crassociati/openWall/README.md

openWall
========

vertical plotting system
