crassociati/openWall/documents/openWall_instructionSet.pdf

# openWall

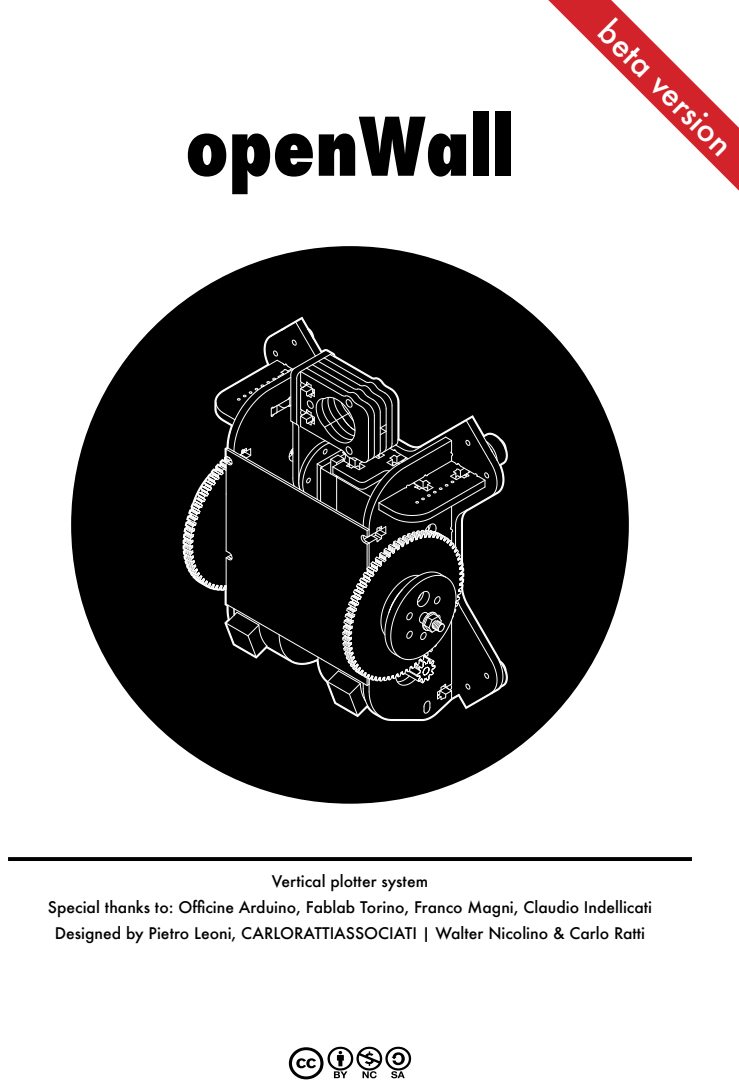
[picture p1: page 1]
beta version

Vertical plotter system

Special thanks to: Officine Arduino, Fablab Torino, Franco Magni, Claudio Indellicati
Designed by Pietro Leoni, carlorattiassociati | Walter Nicolino & Carlo Ratti

# connections and components

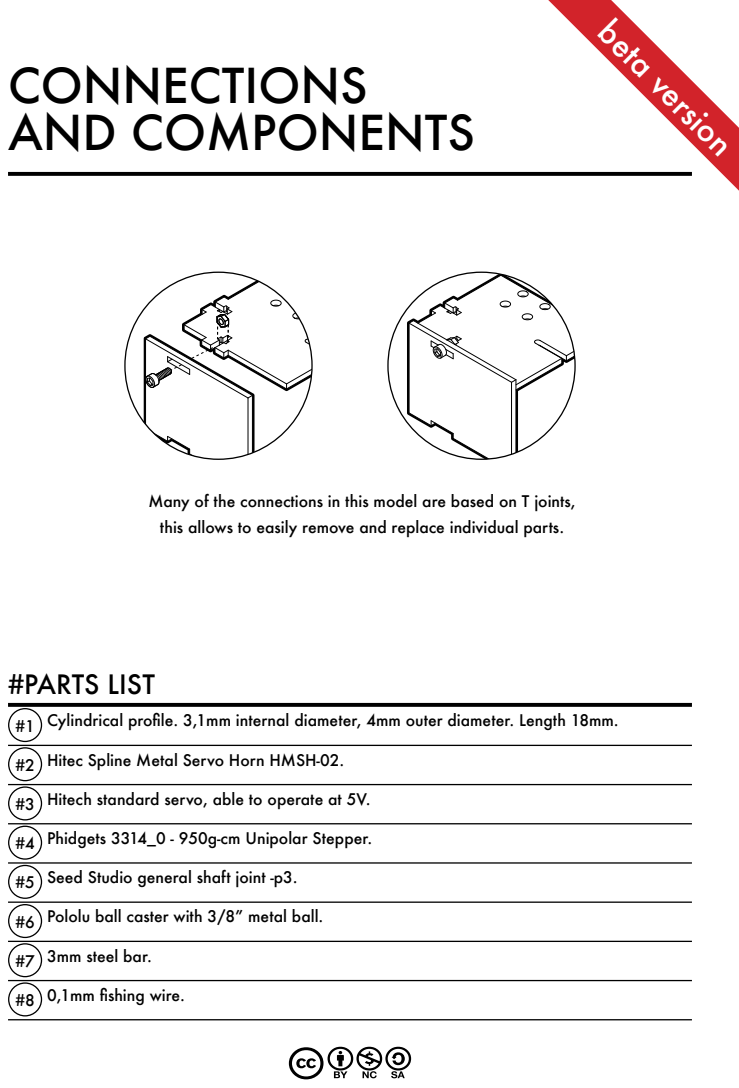
[picture p2: page 2]
beta version; #parts list

Many of the connections in this model are based on T joints,
this allows to easily remove and replace individual parts.

#1 Cylindrical profile. 3,1mm internal diameter, 4mm outer diameter. Length 18mm.
#2 Hitec Spline Metal Servo Horn HMSH-02.
#3 Hitech standard servo, able to operate at 5V.
#4 Phidgets 3314_0 - 950g-cm Unipolar Stepper.
#5 Seed Studio general shaft joint -p3.
#6 Pololu ball caster with 3/8” metal ball.
#7 3mm steel bar.
#8 0,1mm fishing wire.

# assembly

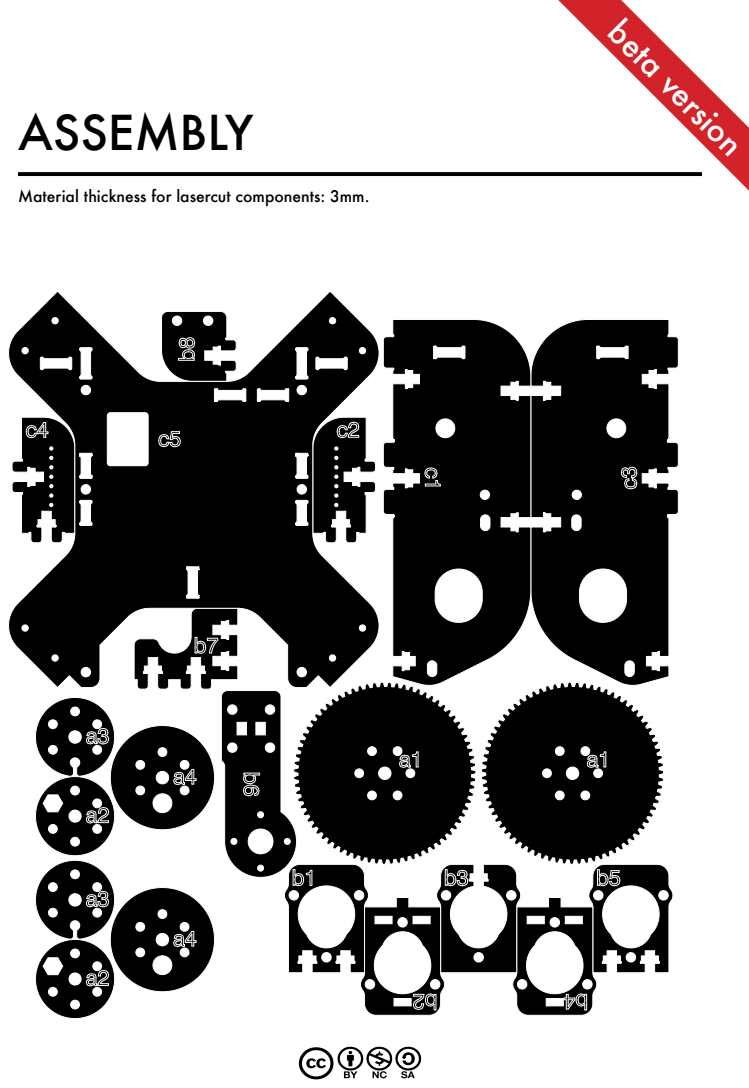
[picture p3: page 3]
beta version

Material thickness for lasercut components: 3mm.

# coils

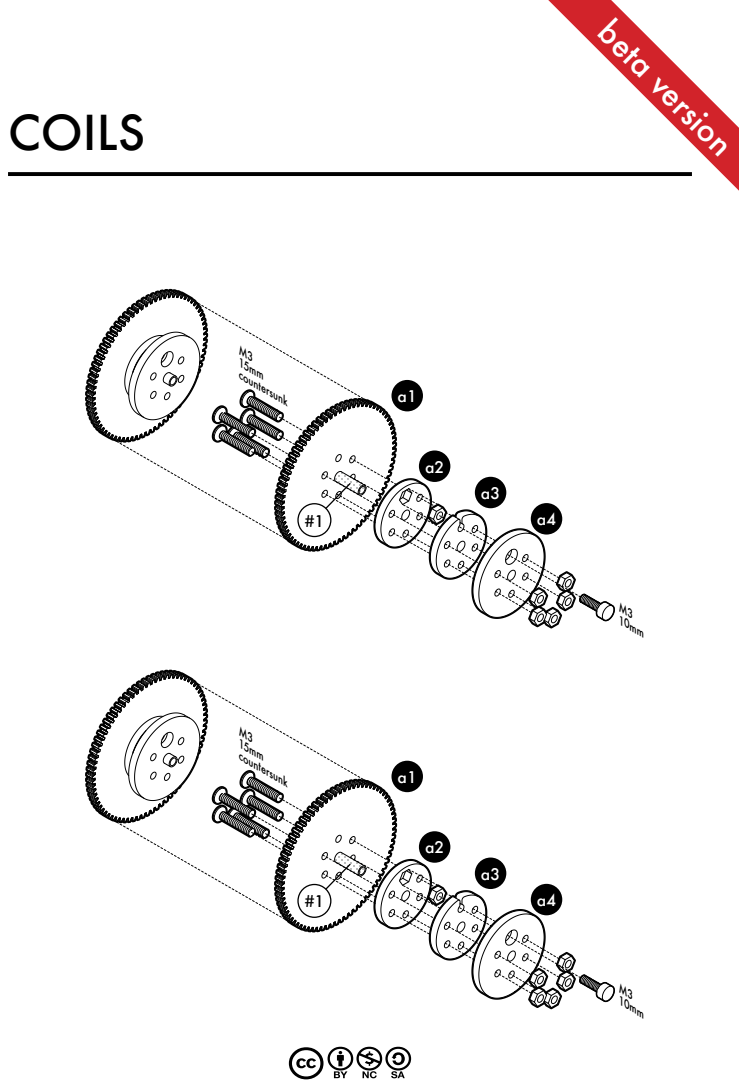
[picture p4: page 4]
beta version; M3 15mm countersunk

# servo and pen holder

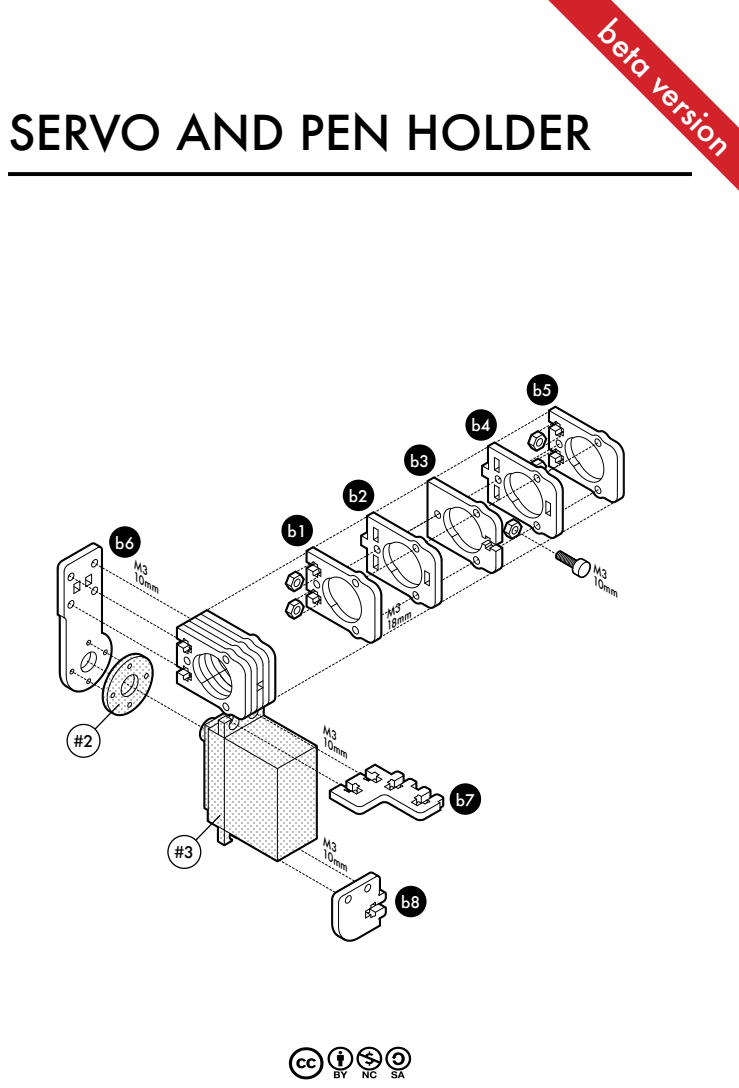
[picture p5: page 5]
beta version

# engines support

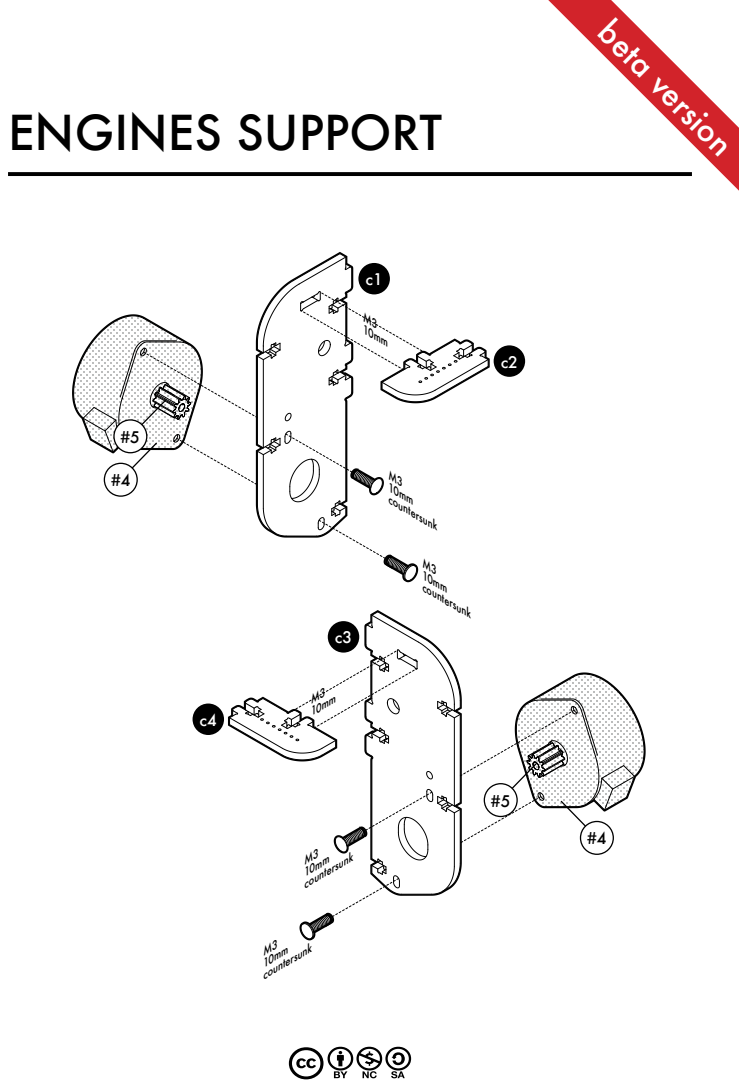
[picture p6: page 6]
beta version; M3 10mm countersunk; countersunk

# chassis

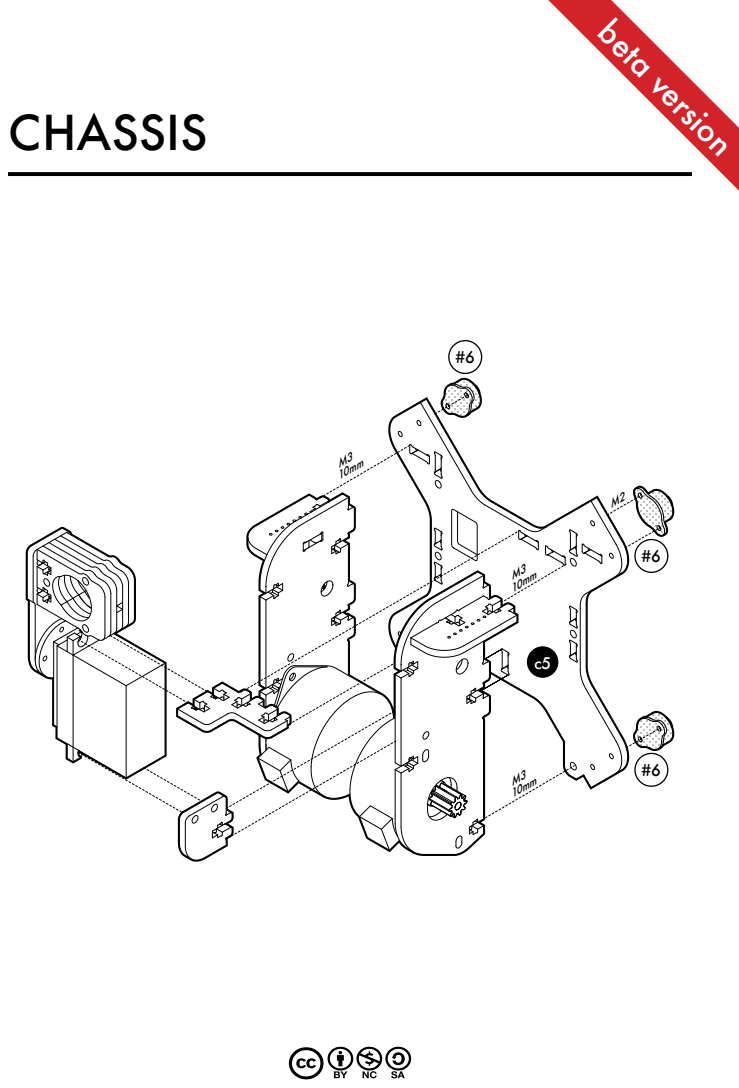
[picture p7: page 7]
beta version

# Coils axis

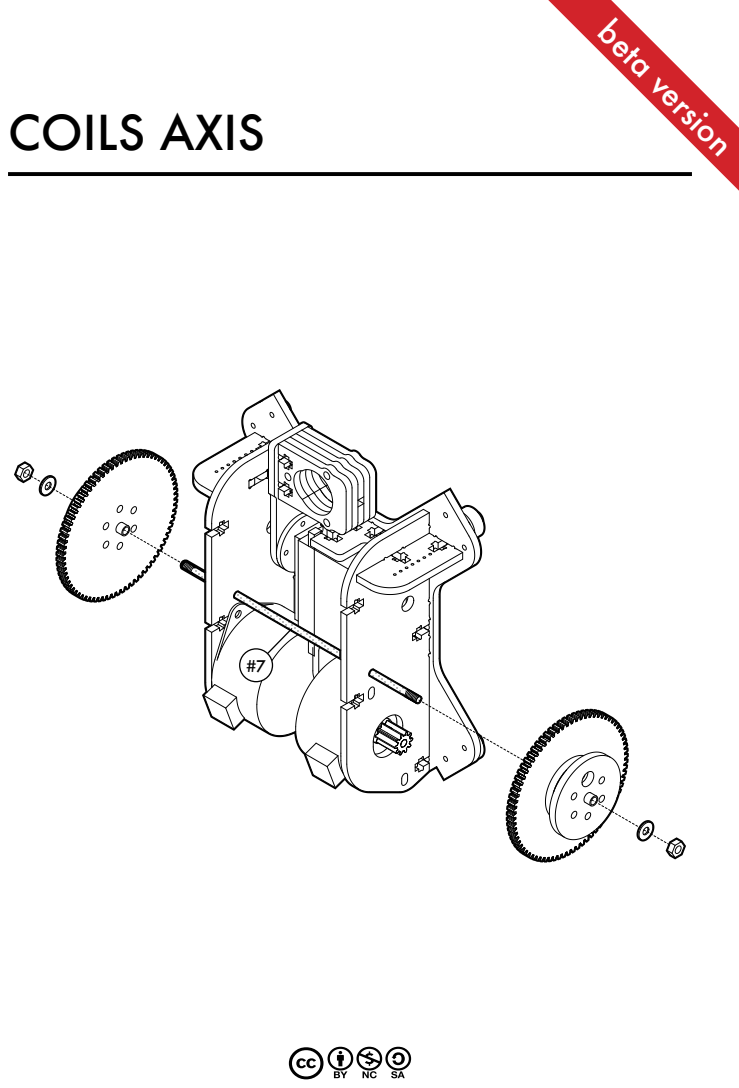
[picture p8: page 8]
beta version

# cables and marker

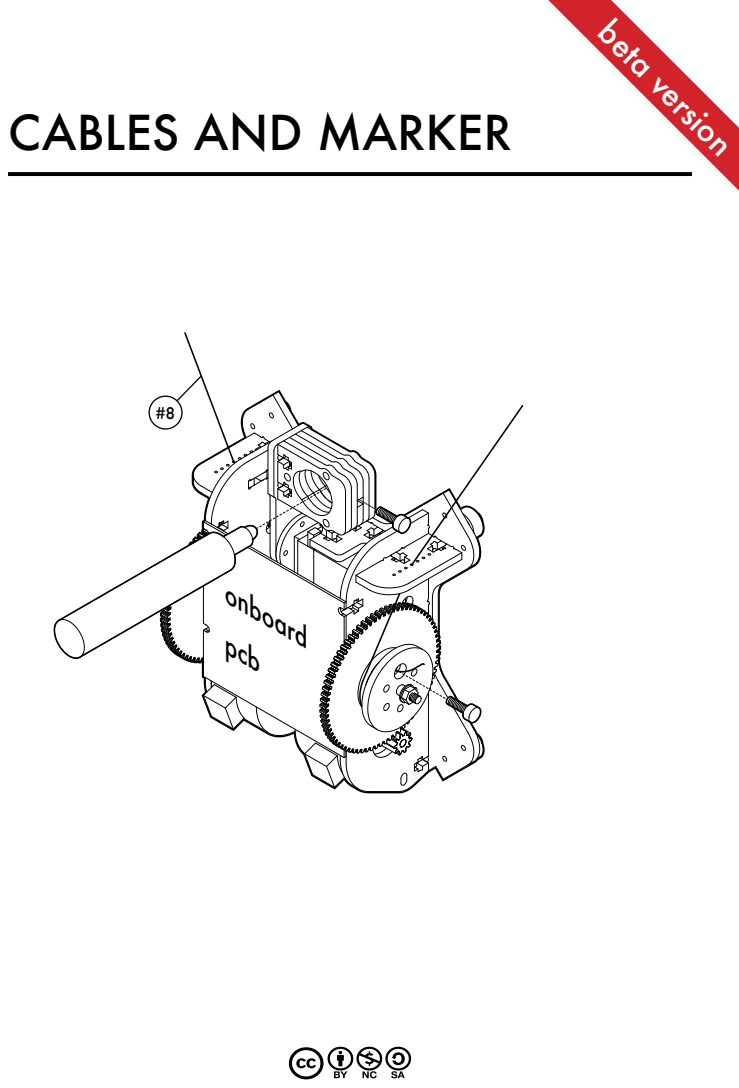
[picture p9: page 9]
beta version; onboard pcb

# hardware

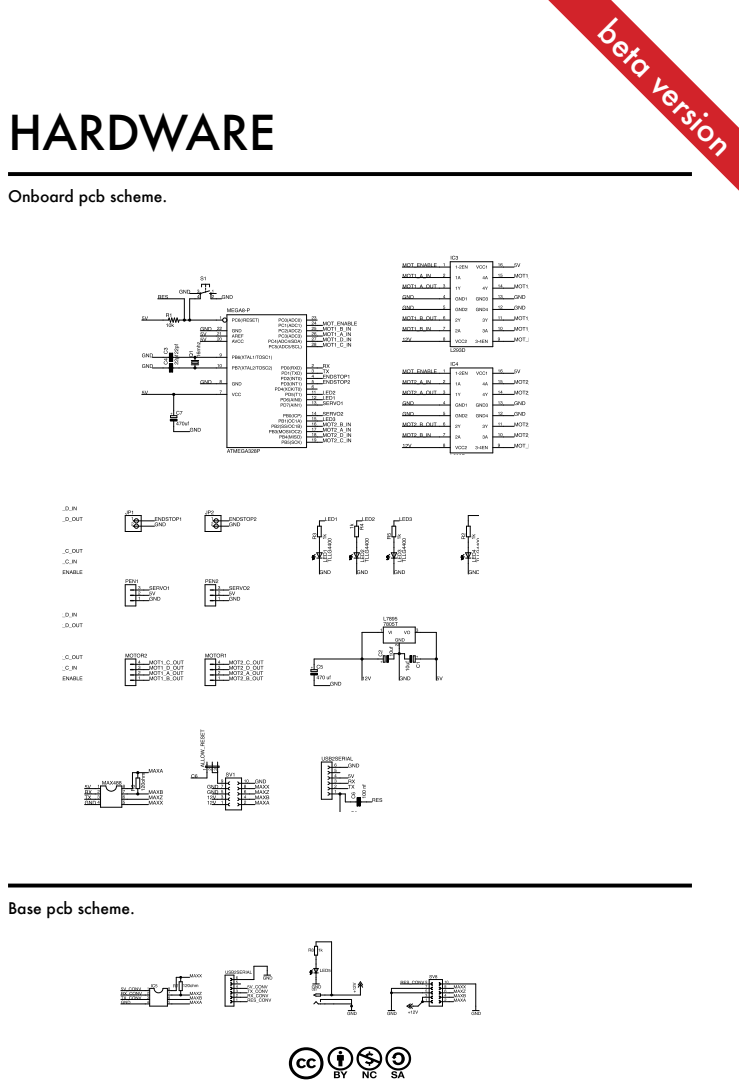
[picture p10: page 10]
beta version

Onboard pcb scheme.

Base pcb scheme.

# hardware

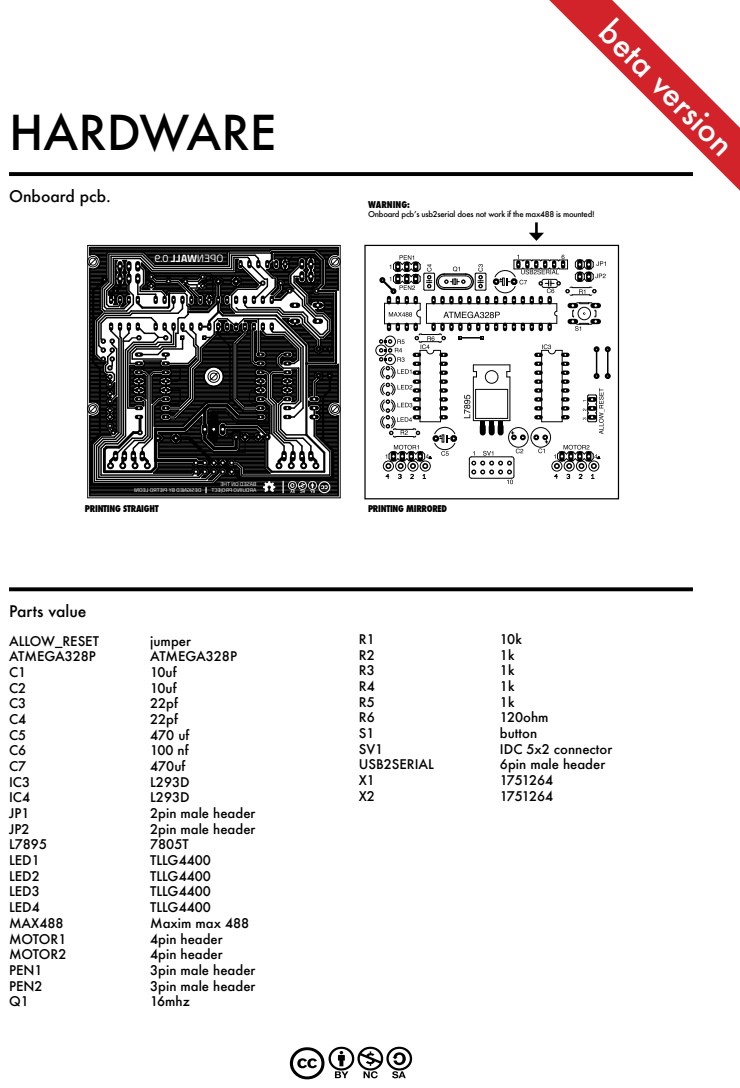
[picture p11: page 11]

warning:
Onboard pcb’s usb2serial does not work if the max488 is mounted!

# hardware

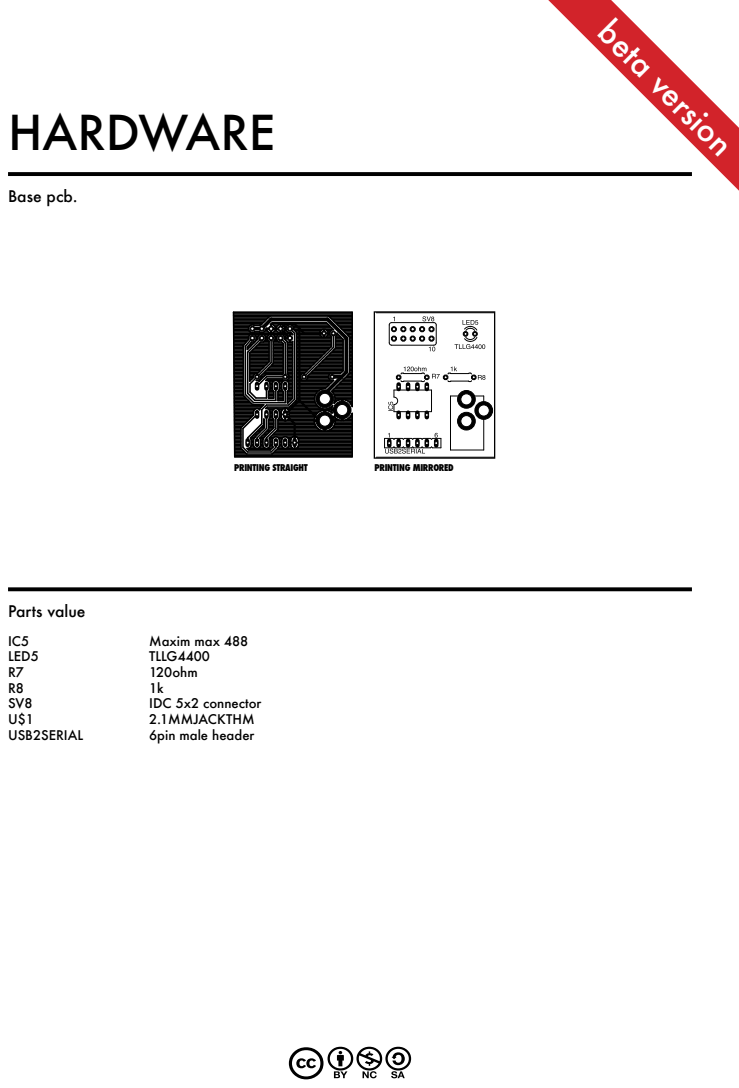
[picture p12: page 12]
beta version; Base pcb.; Parts value; Maxim max 488; LED5; TLLG4400; 120ohm; IDC 5x2 connector; 2.1MMJACKTHM; USB2SERIAL; 6pin male header; printing straight; printing mirrored

# beta version
