crassociati/openWall/documents/openWall_1.0_chassis.pdf

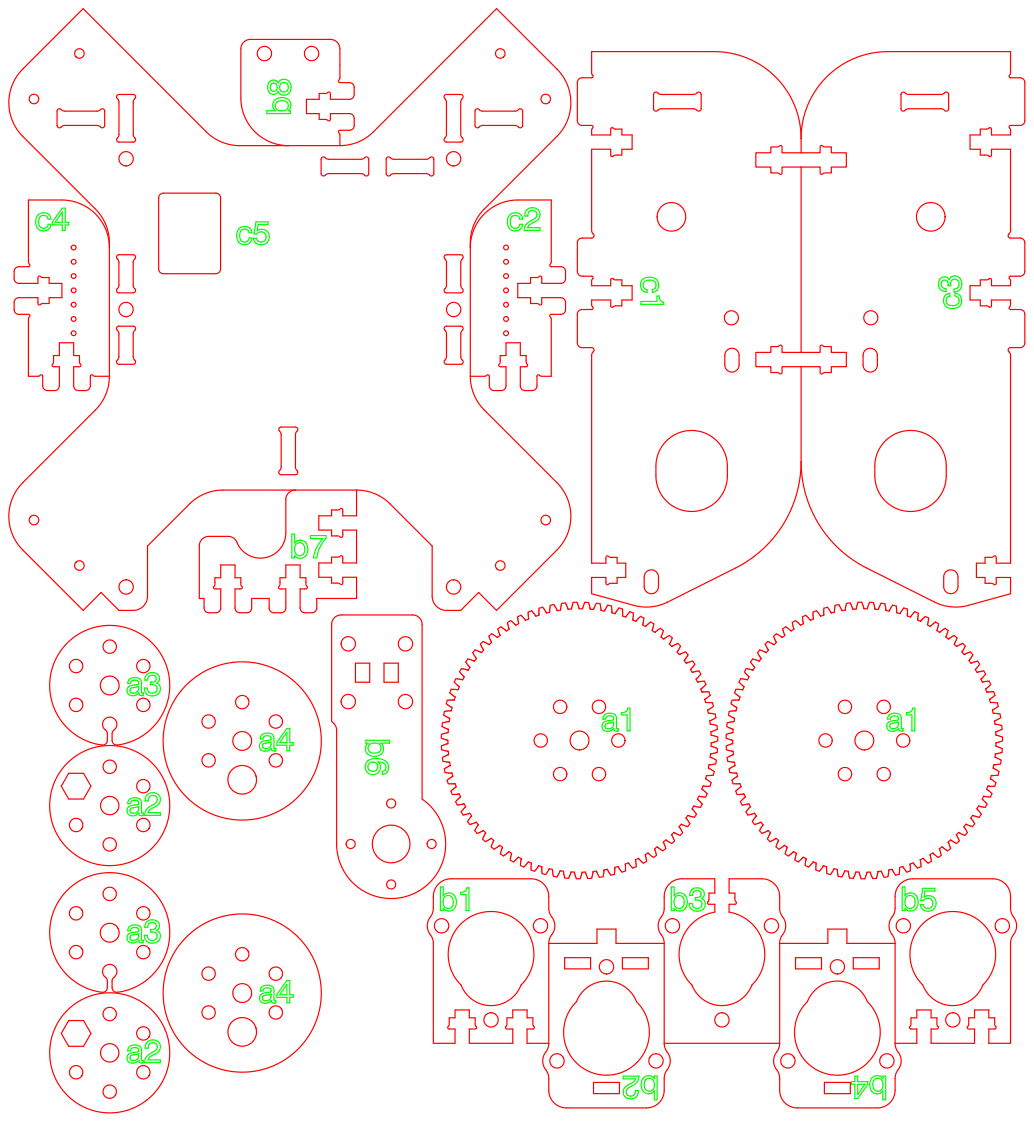
[picture p13: page 1]
