crassociati/openWall/circuits/openWall_BasePCB.brd

## EAGLE design circuits/openWall_BasePCB.brd (2014-04-22)

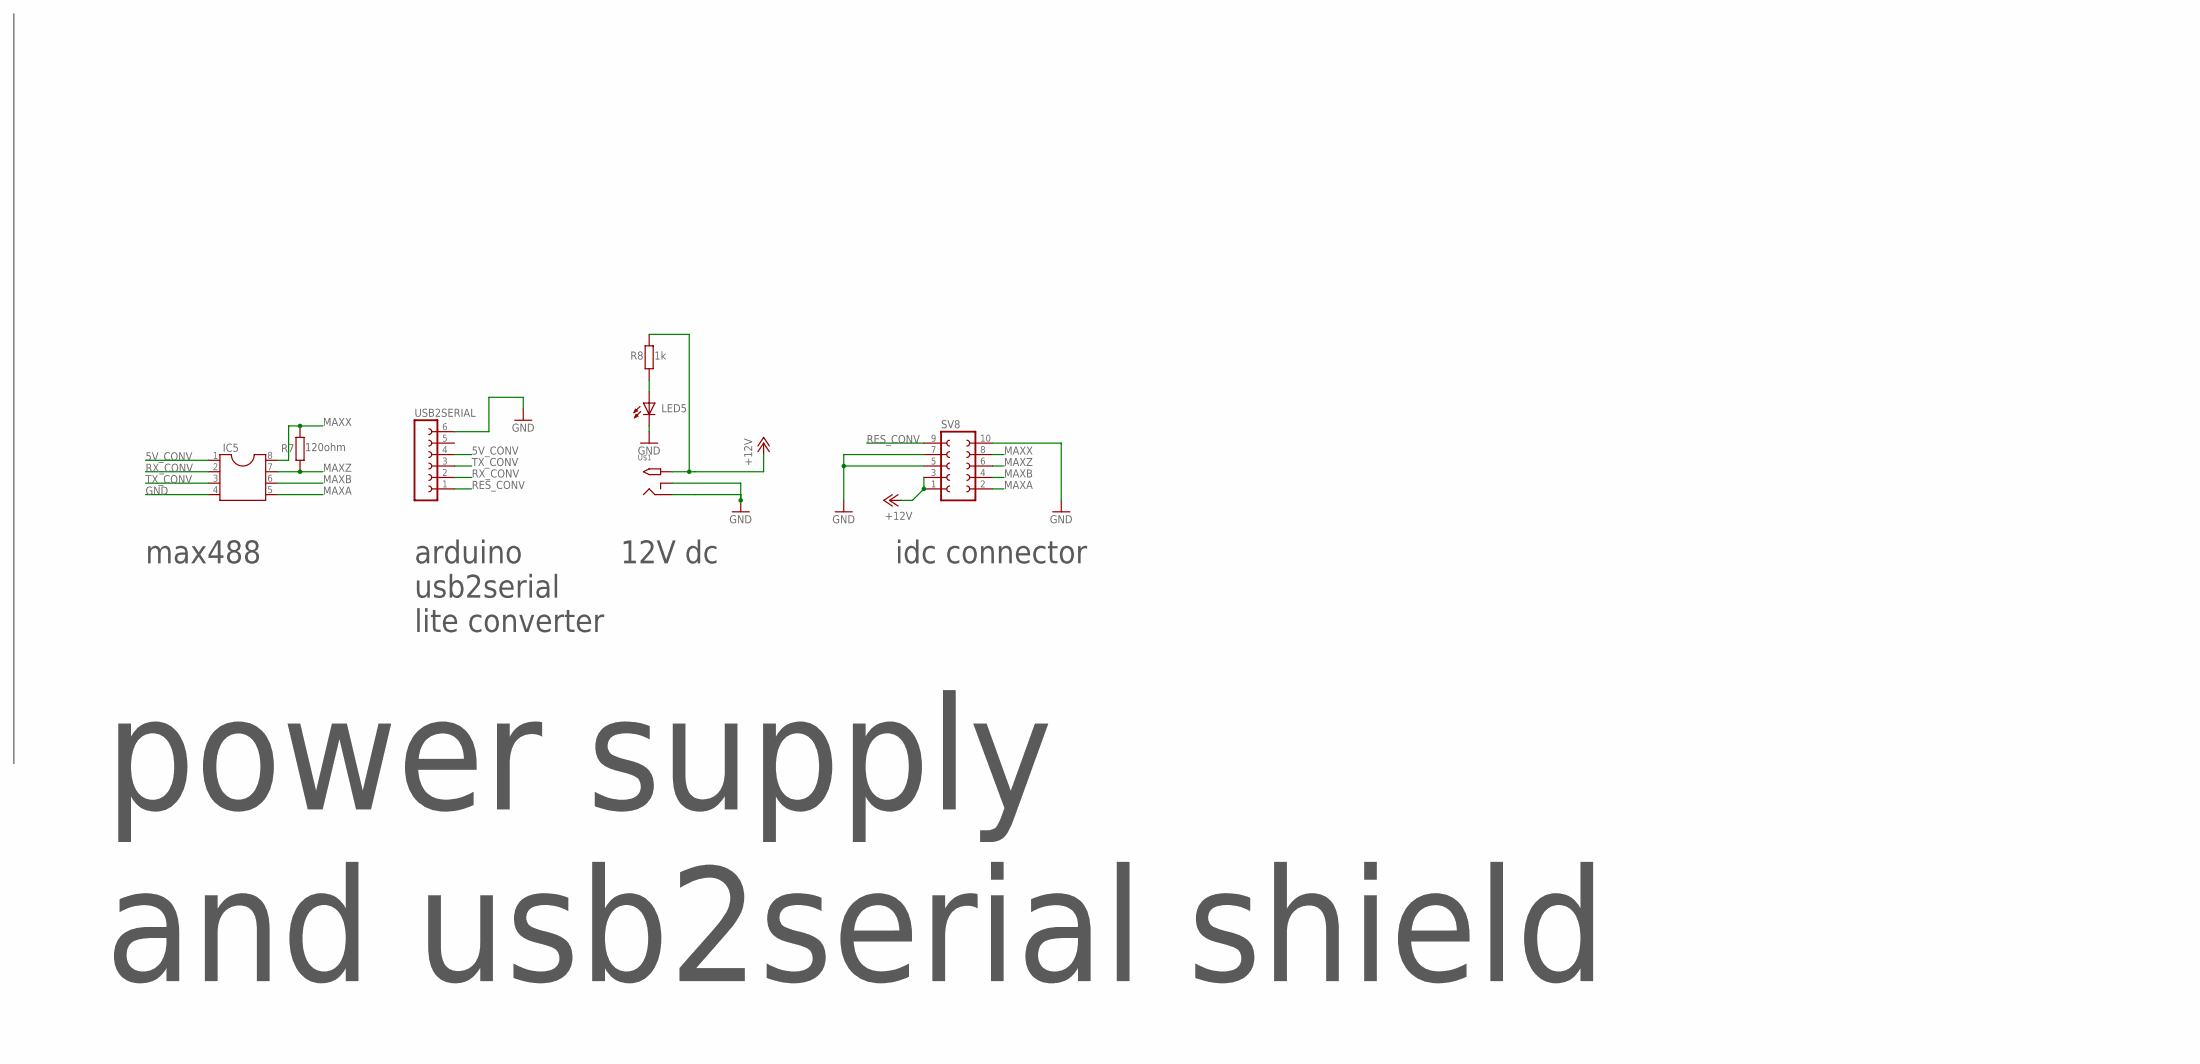
[picture p14: schematic openWall_BasePCB.sch]

Parts:
IC5: DIL8; DIL08
LED5: TLLG4400; LED3MM
R7: 120ohm; 0207/7
R8: 1k; 0207/7
SV8: FE05-2
U$1: 2.1MMJACKTHM; PJ-102A
USB2SERIAL: FE06-1; FE06

Connections:
5V_CONV: IC5.1, USB2SERIAL.4
12V: R8.2, U$1.TIP
+12V: SV8.1, SV8.3
GND: IC5.4, LED5.K (C), SV8.5, SV8.7, SV8.10, U$1.RING, U$1.RING_SW, USB2SERIAL.6
MAXA: IC5.5, SV8.2
MAXB: IC5.6, SV8.4
MAXX: IC5.8, R7.2, SV8.8
MAXZ: IC5.7, R7.1, SV8.6
unnamed: LED5.A, R8.1
RES_CONV: SV8.9, USB2SERIAL.1
RX_CONV: IC5.2, USB2SERIAL.2
TX_CONV: IC5.3, USB2SERIAL.3

Notes on the sheet:
arduino usb2serial lite converter
max488
12V dc
idc connector
power supply and usb2serial shield

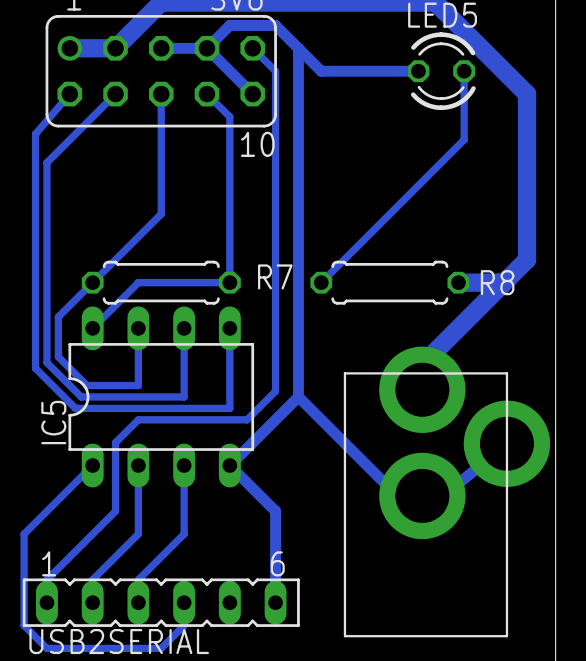
[picture p15: board openWall_BasePCB.brd from above]

Board: 2 copper layers, 7 parts (0 on the bottom side), 12 nets.
