crassociati/openWall/circuits/openWall_onBoardPCB.brd

## EAGLE design circuits/openWall_onBoardPCB.brd (2014-04-22)

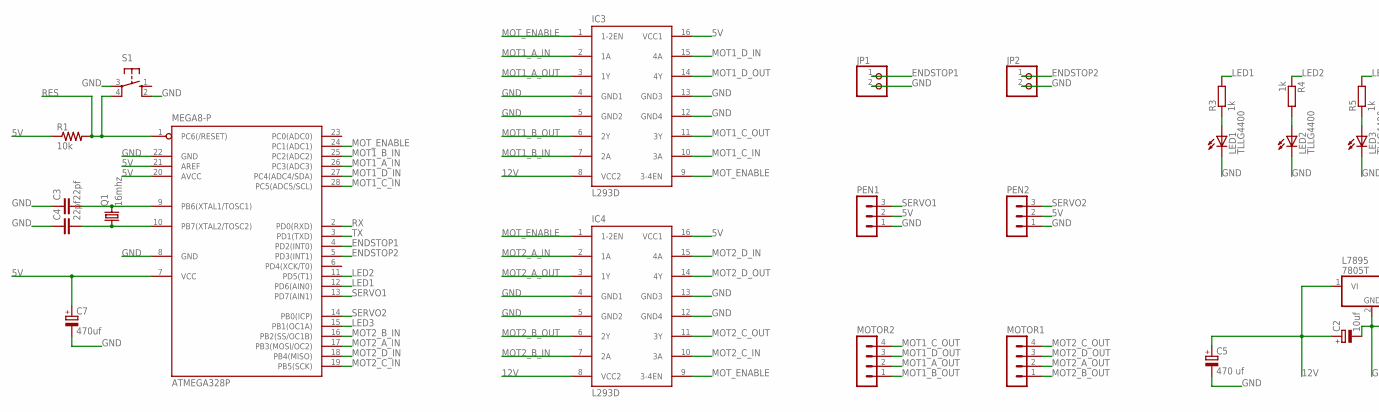
[picture p16: schematic openWall_onBoardPCB.sch, part in row 1, column 1]

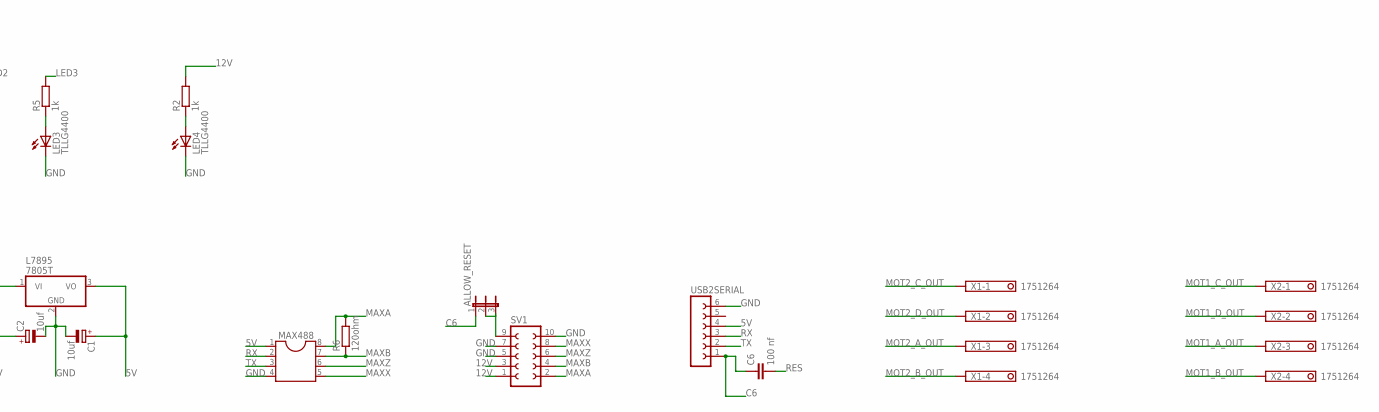
[picture p17: schematic openWall_onBoardPCB.sch, part in row 1, column 2]

Parts:
ALLOW_RESET: JP2E; JP2
ATMEGA328P: MEGA8-P; DIL28-3
C1, C2: 10uf; E2,5-6
C3, C4: 22pf; C025-030X050
C5: 470 uf; E5-6
C6: 100 nf; C050-024X044
C7: 470uf; E5-6
IC3, IC4: L293D; DIL16
JP1, JP2: PINHD-1X2; 1X02
L7895: 7805T; TO220H
LED1, LED2, LED3, LED4: TLLG4400; LED3MM
MAX488: DIL8; DIL08
MOTOR1, MOTOR2: MA04-1
PEN1, PEN2: MA03-1
Q1: 16mhz; HC49/S
R1: 10k; 0207/7
R2: 1k; 0207/7
R3, R4, R5: 1k; 0309V
R6: 120ohm; 0207/7
S1: 10-XX; B3F-10XX
SV1: FE05-2
USB2SERIAL: FE06-1; FE06
X1, X2: 1751264

Connections:
5V: ATMEGA328P.7 (VCC), ATMEGA328P.20 (AVCC), ATMEGA328P.21 (AREF), C1.+, C7.+, IC3.16 (VCC1), IC4.16 (VCC1), L7895.3 (VO), MAX488.1, PEN1.2, PEN2.2, R1.1, USB2SERIAL.4
12V: C2.+, C5.+, IC3.8 (VCC2), IC4.8 (VCC2), L7895.1 (VI), R2.2, SV1.1, SV1.3
C6: ALLOW_RESET.1, C6.1, USB2SERIAL.1
ENDSTOP1: ATMEGA328P.4 (PD2(INT0)), JP1.1
ENDSTOP2: ATMEGA328P.5 (PD3(INT1)), JP2.1
GND: ATMEGA328P.8 (GND), ATMEGA328P.22 (GND), C1.-, C2.-, C3.1, C4.1, C5.-, C7.-, IC3.4 (GND1), IC3.5 (GND2), IC3.12 (GND4), IC3.13 (GND3), IC4.4 (GND1), IC4.5 (GND2), IC4.12 (GND4), IC4.13 (GND3), JP1.2, JP2.2, L7895.2 (GND), LED1.K (C), LED2.K (C), LED3.K (C), LED4.K (C), MAX488.4, PEN1.1, PEN2.1, S1.2 (S1), S1.3, SV1.5, SV1.7, SV1.10, USB2SERIAL.6
LED1: ATMEGA328P.12 (PD6(AIN0)), R3.2
LED2: ATMEGA328P.11 (PD5(T1)), R4.1
LED3: ATMEGA328P.15 (PB1(OC1A)), R5.2
MAXA: MAX488.8, R6.2, SV1.2
MAXB: MAX488.7, R6.1, SV1.4
MAXX: MAX488.5, SV1.8
MAXZ: MAX488.6, SV1.6
MOT1_A_IN: ATMEGA328P.26 (PC3(ADC3)), IC3.2 (1A)
MOT1_A_OUT: IC3.3 (1Y), MOTOR2.2, X2.3
MOT1_B_IN: ATMEGA328P.25 (PC2(ADC2)), IC3.7 (2A)
MOT1_B_OUT: IC3.6 (2Y), MOTOR2.1, X2.4
MOT1_C_IN: ATMEGA328P.28 (PC5(ADC5/SCL)), IC3.10 (3A)
MOT1_C_OUT: IC3.11 (3Y), MOTOR2.4, X2.1
MOT1_D_IN: ATMEGA328P.27 (PC4(ADC4/SDA)), IC3.15 (4A)
MOT1_D_OUT: IC3.14 (4Y), MOTOR2.3, X2.2
MOT2_A_IN: ATMEGA328P.17 (PB3(MOSI/OC2)), IC4.2 (1A)
MOT2_A_OUT: IC4.3 (1Y), MOTOR1.2, X1.3
MOT2_B_IN: ATMEGA328P.16 (PB2(SS/OC1B)), IC4.7 (2A)
MOT2_B_OUT: IC4.6 (2Y), MOTOR1.1, X1.4
MOT2_C_IN: ATMEGA328P.19 (PB5(SCK)), IC4.10 (3A)
MOT2_C_OUT: IC4.11 (3Y), MOTOR1.4, X1.1
MOT2_D_IN: ATMEGA328P.18 (PB4(MISO)), IC4.15 (4A)
MOT2_D_OUT: IC4.14 (4Y), MOTOR1.3, X1.2
MOT_ENABLE: ATMEGA328P.24 (PC1(ADC1)), IC3.1 (1-2EN), IC3.9 (3-4EN), IC4.1 (1-2EN), IC4.9 (3-4EN)
unnamed: ATMEGA328P.10 (PB7(XTAL2/TOSC2)), C4.2, Q1.1
unnamed: ATMEGA328P.9 (PB6(XTAL1/TOSC1)), C3.2, Q1.2
unnamed: LED1.A, R3.1
unnamed: LED4.A, R2.1
unnamed: LED2.A, R4.2
unnamed: LED3.A, R5.1
unnamed: ALLOW_RESET.2, ALLOW_RESET.3
RES: ATMEGA328P.1 (PC6(/RESET)), C6.2, R1.2, S1.4 (P1)
RX: ATMEGA328P.2 (PD0(RXD)), MAX488.2, USB2SERIAL.3
SERVO1: ATMEGA328P.13 (PD7(AIN1)), PEN1.3
SERVO2: ATMEGA328P.14 (PB0(ICP)), PEN2.3
TX: ATMEGA328P.3 (PD1(TXD)), MAX488.3, USB2SERIAL.2

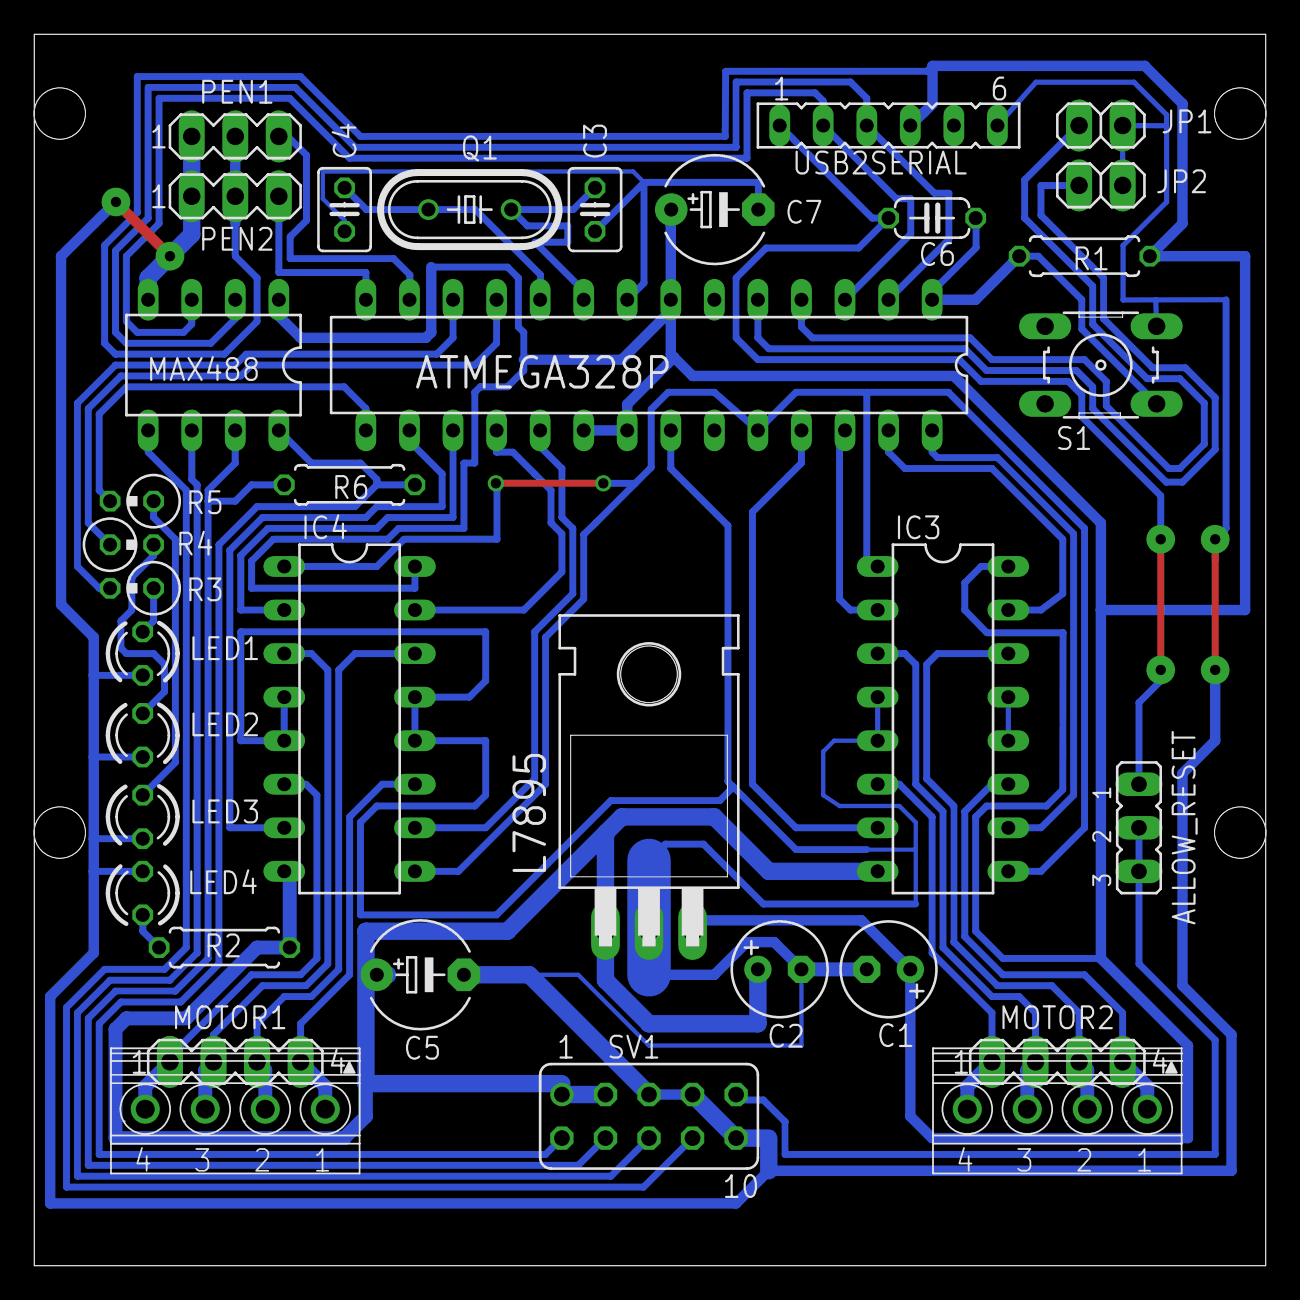
[picture p18: board openWall_onBoardPCB.brd from above]

Board: 2 copper layers, 71.8 x 71.8 mm, 35 parts (0 on the bottom side), 42 nets.
